nicholasgrummon/t8bb/KiCAD/PC Counter Standalone/Assembly Files/BOM.xlsx

Comment | Designator | Footprint | LCSC Part Number
Tactile button | B1,B2 | 6.1x3.7 | C7419906
220R | R1,R2 | 0603 | C17557
470R | R3 | 0603 | C17710
22uF | C1 | D4xL5.4 | C4747977
LED | L1,L2,L3,L4 | 0805 | C2296
XD74LS14 | U1 | DIP-14 | C609749
5P 2.54mm | J1 | P=2.54mm | C6332198
2P 2.54mm | J2,J3 | P=2.54mm | C492401
