nicholasgrummon/t8bb/KiCAD/MemPCB/Assembly Files/BOM.xlsx

Comment | Designator | Footprint | LCSC Part Number
LEDY | L1,L2,L3,L4 | 0805 | C2296
LEDB | L5,L6,L7,L8,L9,L10,L11,L12 | 0805 | C7371912
ADDR | J1 | P=2.54mm | C6332198
PWR | J3 | P=2.54mm | C492401
100R | R1,R2,R3,R4,R5,R6,R7,R8,R9,R10,R11,R12 | 0805 | C2907294
75HC04 | U1,U2 | DIP-14 | C18723497
