nicholasgrummon/t8bb/KiCAD/ALU_PCB/ALU_PCB.step

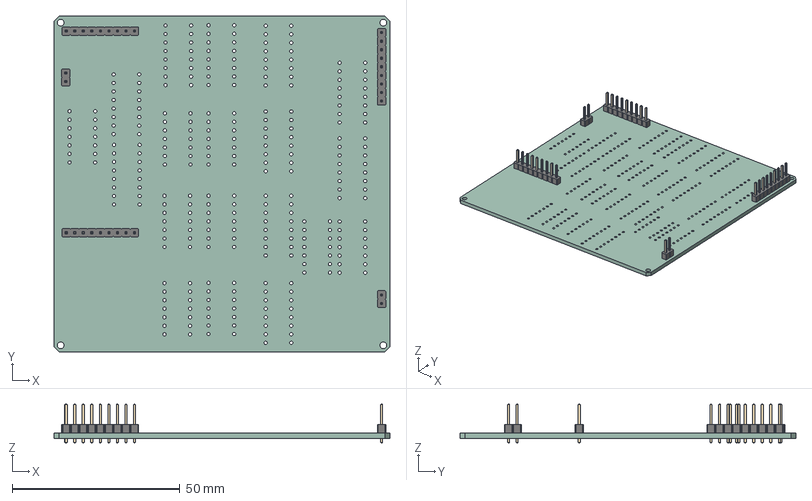
[picture p2: CAD file, 2026-06-02]
KiCAD/ALU_PCB/ALU_PCB.step
100.0 x 100.0 x 11.5 mm
PinHeader_1x09_P254mm_Vertical x 3
PinHeader_1x02_P254mm_Vertical x 2
ALU_PCB_PCB
