nicholasgrummon/t8bb/KiCAD/Registers Standalone/RegisterFile_PCB.step

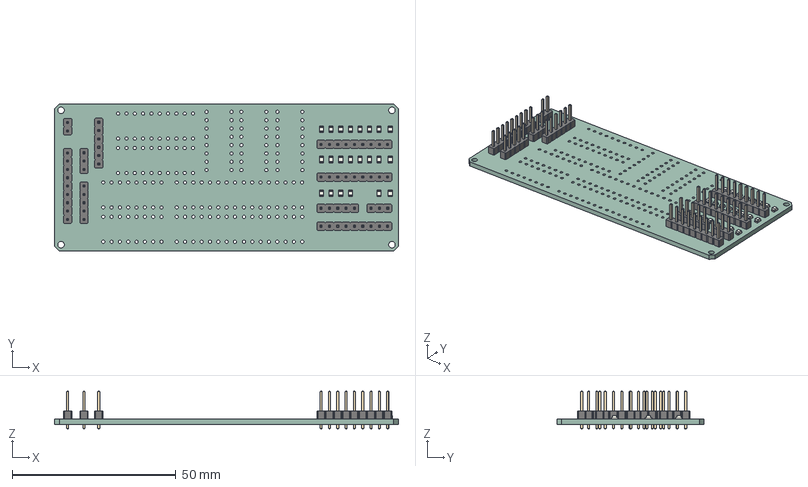
[picture p3: CAD file, 2026-06-02]
KiCAD/Registers Standalone/RegisterFile_PCB.step
105.0 x 45.0 x 11.5 mm
LED_0805_2012Metric x 22
PinHeader_1x09_P254mm_Vertical x 4
PinHeader_1x05_P254mm_Vertical x 2
PinHeader_1x02_P254mm_Vertical
PinHeader_1x03_P254mm_Vertical x 2
PinHeader_1x06_P254mm_Vertical
RegisterFile_PCB_PCB
