nicholasgrummon/t8bb/(commit log)

2026-06-02 Add README.md for KiCAD schematics and project history
    Document the history and challenges faced with the KiCAD project.
2026-06-02 Add base files
    [100x100 Panel BOM.csv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]
2026-06-02 Add stand-alone versions
    [BOM.xlsx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]
